rayen-yadir/cable-cut-detection-system/images/fig3.3_signal_oscilloscope.jpg

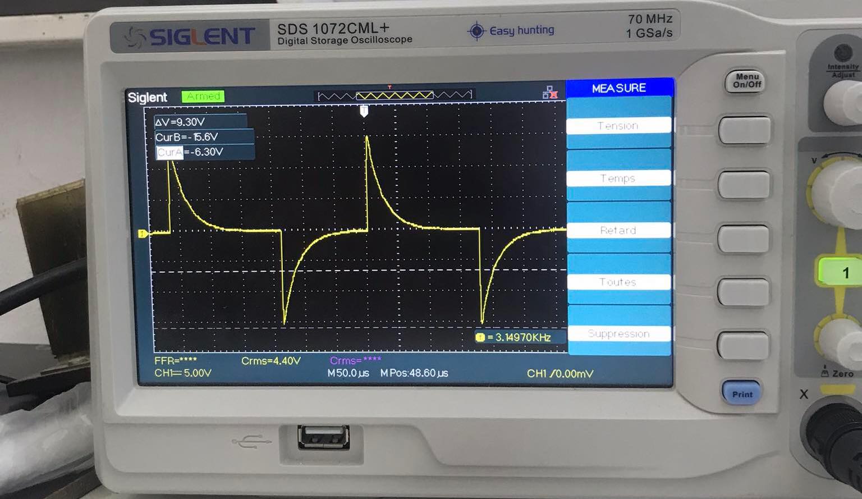
images/fig3.3_signal_oscilloscope.jpg
