rayen-yadir/cable-cut-detection-system/images/fig3.6_tore_ferrite.jpg

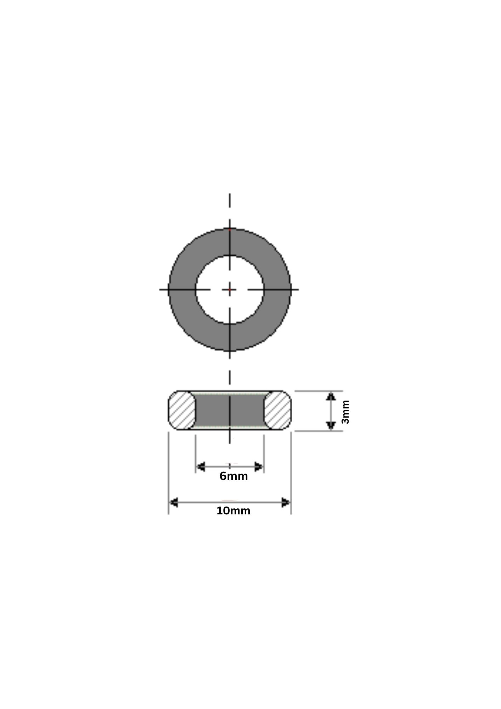
images/fig3.6_tore_ferrite.jpg
