rayen-yadir/cable-cut-detection-system/images/fig3.7_dimension_tore.jpg

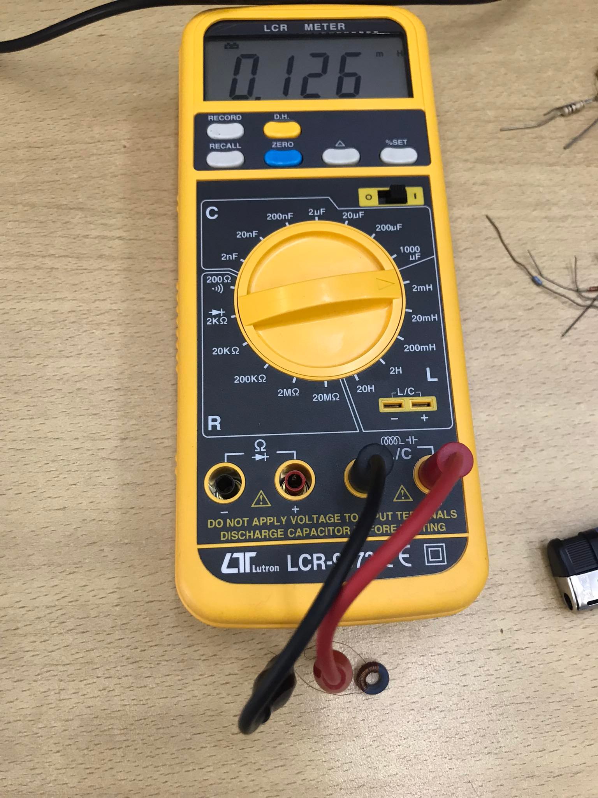
images/fig3.7_dimension_tore.jpg
