rayen-yadir/cable-cut-detection-system/images/fig3.9b_mesure_inductance_99mH.jpg

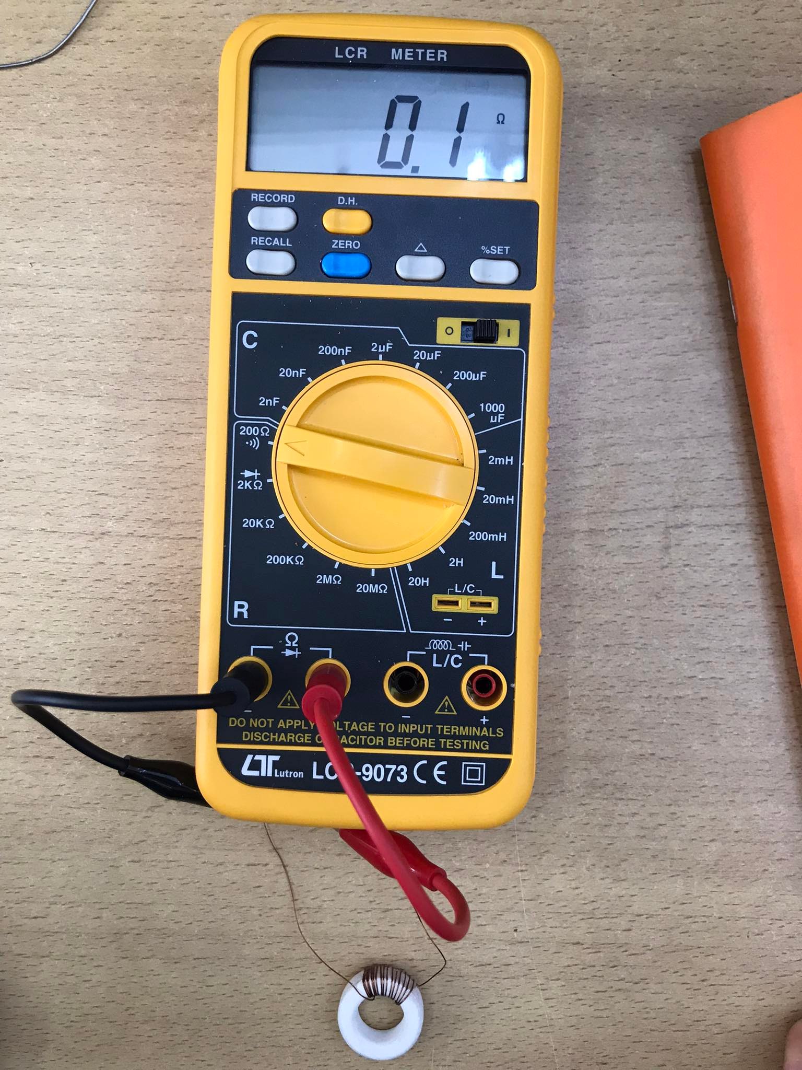
images/fig3.9b_mesure_inductance_99mH.jpg
