rayen-yadir/cable-cut-detection-system/images/fig3.10_transfo_grand_noyau.jpg

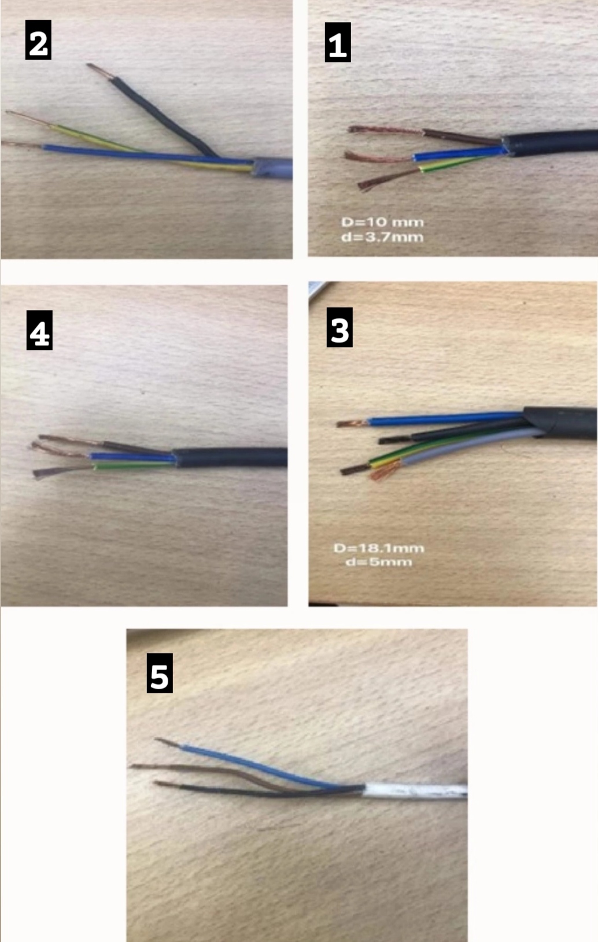
images/fig3.10_transfo_grand_noyau.jpg
