rayen-yadir/cable-cut-detection-system/images/fig4.1_cable_5.jpg

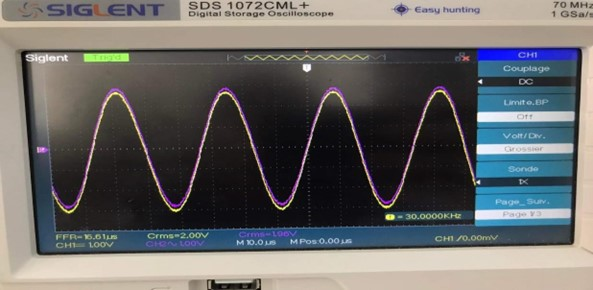
images/fig4.1_cable_5.jpg
