rayen-yadir/cable-cut-detection-system/images/fig4.1_cables_1-2.jpg

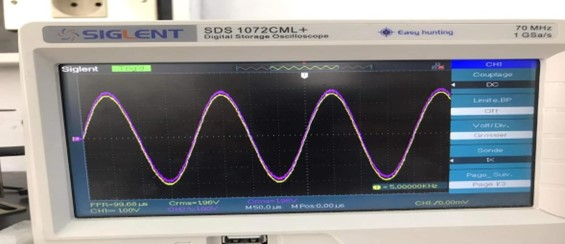
images/fig4.1_cables_1-2.jpg
