rayen-yadir/cable-cut-detection-system/images/fig4.1_cables_3-4.jpg

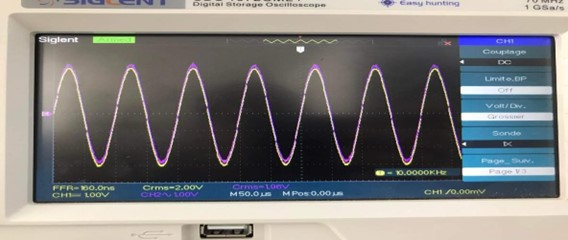
images/fig4.1_cables_3-4.jpg
