rayen-yadir/cable-cut-detection-system/images/fig4.6_bloc_commande_breadboard.jpg

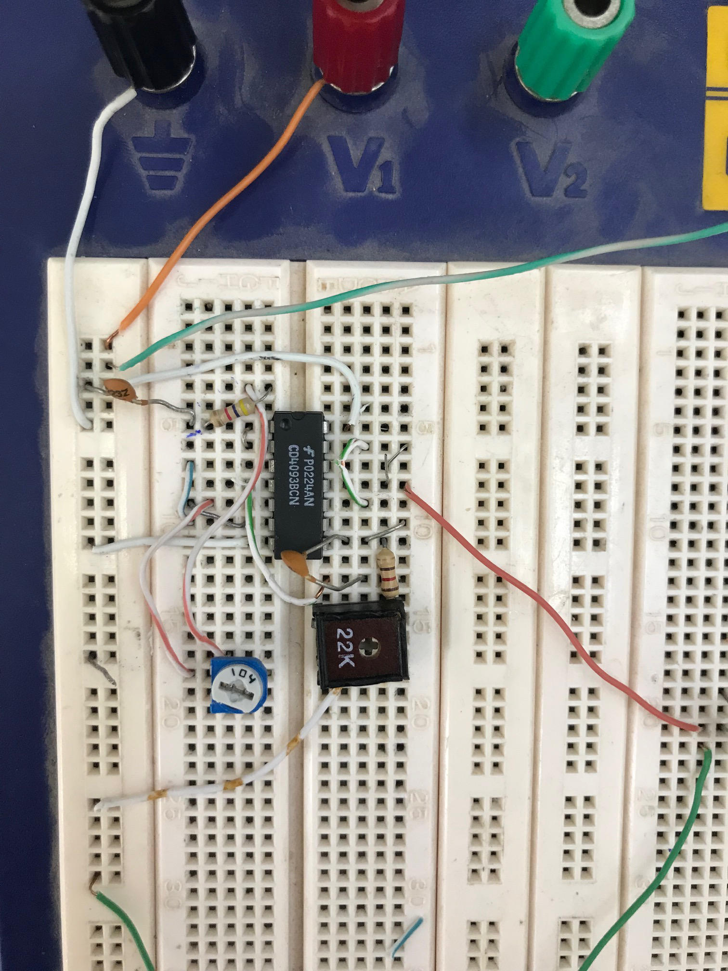
images/fig4.6_bloc_commande_breadboard.jpg
