rayen-yadir/cable-cut-detection-system/images/fig4.7a_signal_impulsion_253Hz.jpg

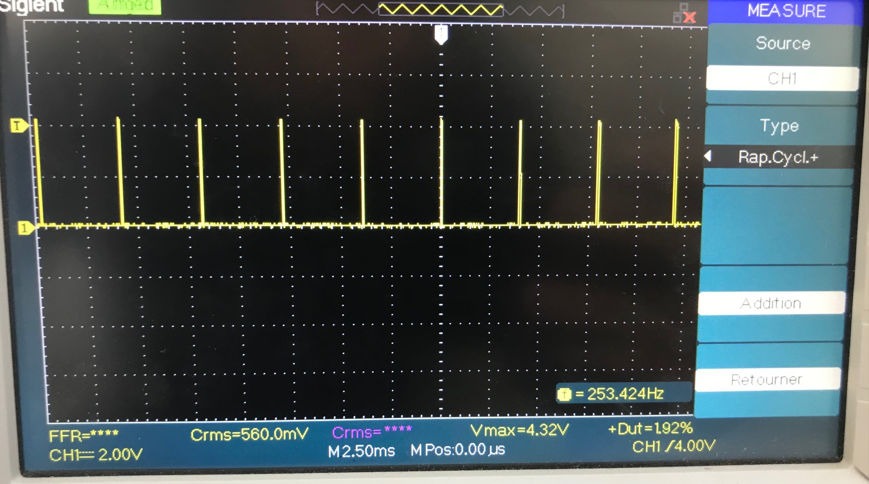
images/fig4.7a_signal_impulsion_253Hz.jpg
