rayen-yadir/cable-cut-detection-system/images/fig4.7b_signal_impulsion_338Hz.jpg

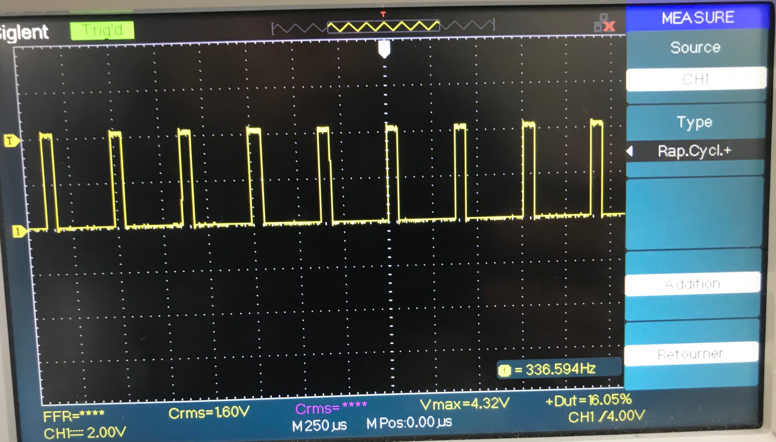
images/fig4.7b_signal_impulsion_338Hz.jpg
