rayen-yadir/cable-cut-detection-system/images/fig4.8_generateur_aperiodique_breadboard.jpg

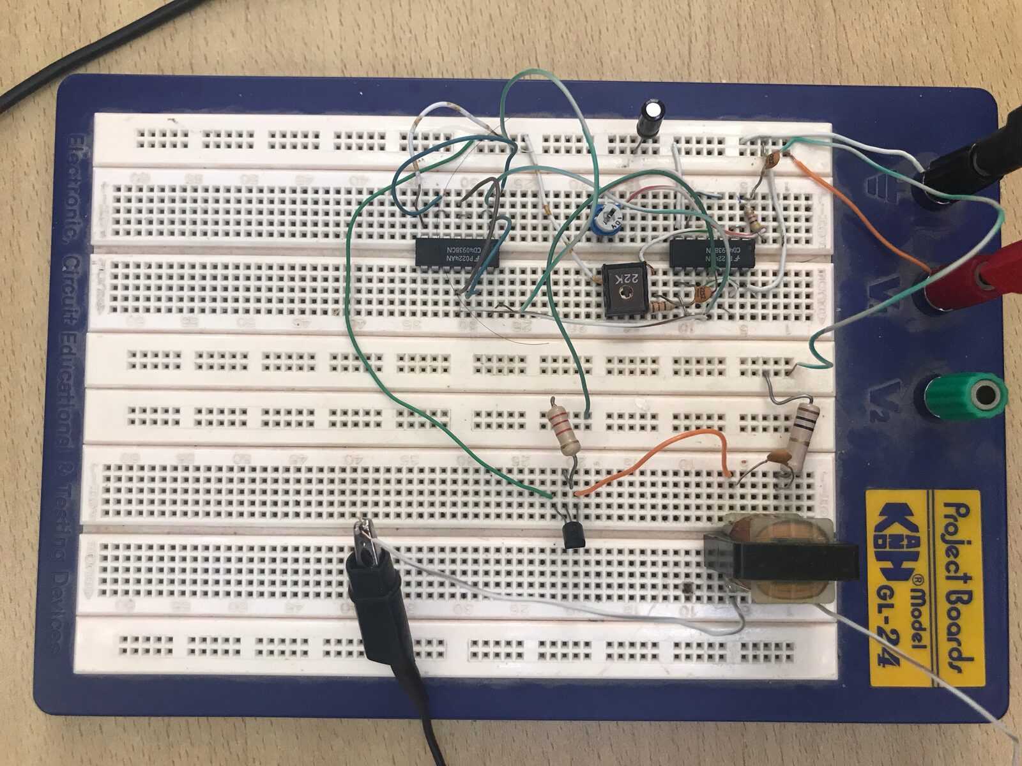
images/fig4.8_generateur_aperiodique_breadboard.jpg
