rayen-yadir/cable-cut-detection-system/images/fig4.9_signal_secondaire_transfo1_59mH.jpg

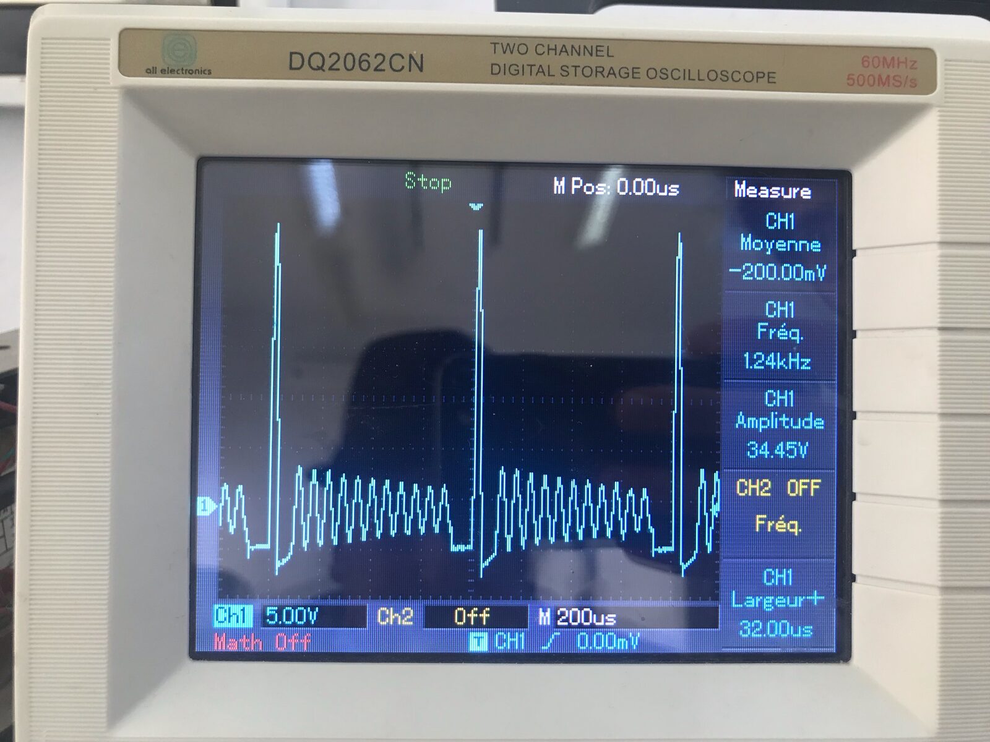
images/fig4.9_signal_secondaire_transfo1_59mH.jpg
