rayen-yadir/cable-cut-detection-system/images/fig4.11_signal_secondaire_transfo2_1mH.jpg

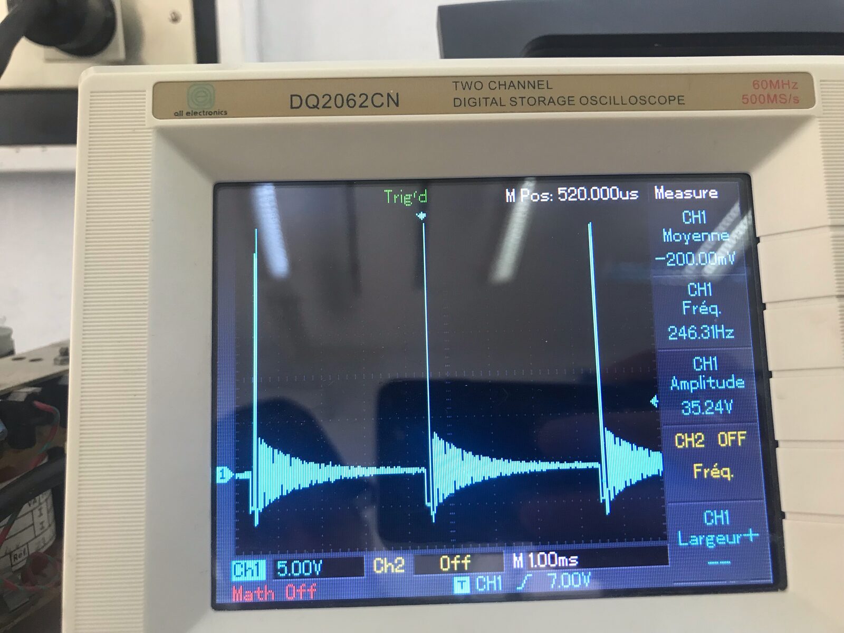
images/fig4.11_signal_secondaire_transfo2_1mH.jpg
