rayen-yadir/cable-cut-detection-system/images/fig4.13_cable_electrique.jpg

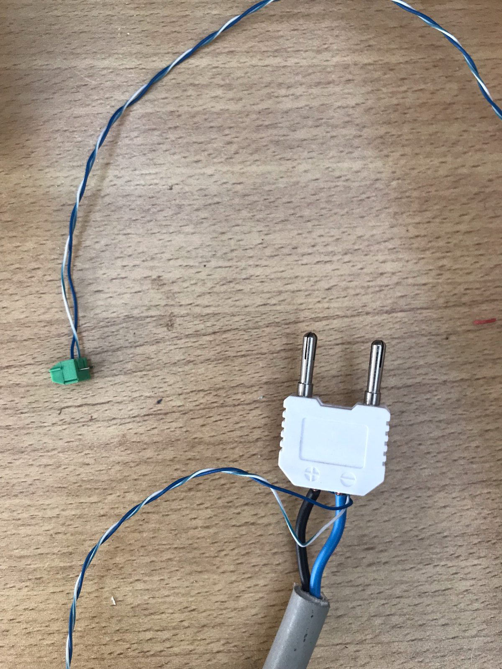
images/fig4.13_cable_electrique.jpg
