rayen-yadir/cable-cut-detection-system/images/fig3.2_montage_circuit_RL.jpg

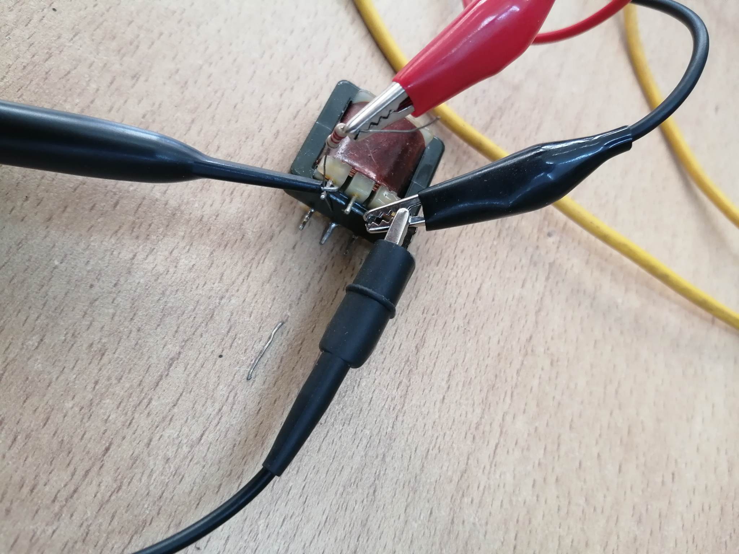
images/fig3.2_montage_circuit_RL.jpg
